WesternHAB/HAB360/README.md

# HAB360

This repository is for WesternU HAB team's VR balloon project. The goal is to fly 360° cameras on a balloon platform. The resulting video/images could then be viewed using VR cameras for outreach purposes.
