WesternHAB/HAB360/L-COM system/Documentation/Images/DrawIO/status_packet.png

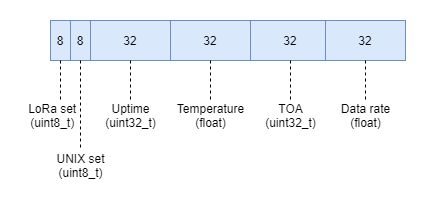
L-COM system/Documentation/Images/DrawIO/status_packet.png
