WesternHAB/HAB360/L-COM system/Documentation/Images/serial_power_interface.jpg

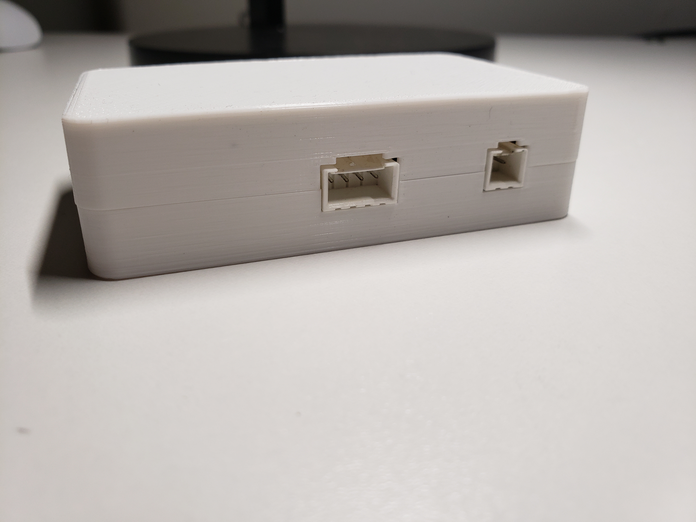
L-COM system/Documentation/Images/serial_power_interface.jpg
