WesternHAB/HAB360/L-COM system/Documentation/LCOM_V2_specifications.xlsx

Sheet: Eagle parts list
Part type: | Capacitors |  |  | Part type: | Resistors |  |  | Part type: | Inductors
Name | Footprint | Value | Notes | Name | Footprint | Value | Notes | Name | Footprint | Value | Notes
C1 | 0805 | 10uF | 50V min | R1 | 0805 | 1K |  | L1 | CD43 | 5.6uH | RLS-567, 12-48V?
C2 | 0805 | 100nF | 50V min | R2 | 0805 | 0R
C3 | 0805 | 100nF |  | R3 | 0805 | 10K
C4 | 0805 | 10uF |  | R4 | 0805 | 10K-Therm | Thermistor | Part type: | Diodes
C5 | 0805 | 1uF |  | R5 | 0805 | 200R |  | Name | Footprint | Model | Notes
C6 | 0805 | 1uF |  | R6 | 0805 | 1K |  | D1 | 0603 | 1N4148WT
C7 | 0805 | 1nF |  | R7 | 0805 | 200R |  | ZD1 | 1206 | MMSZ4690T1G
C8 | 0805 | 100nF |  | R8 | 0805 | 1K8
C9 | 1206 (3216) | 33uF | 10V tantalum | R9 | 0805 | 1K
C10 | 0805 | 10nF |  | R10 | 0805 | 10K |  | Part type: | LEDs
C11 | 0805 | 100nF |  | R11 | 0805 | 4K7 |  | Name | Footprint | Colour | Notes
C12 | 0805 | 100nF |  | R12 | 0805 | 4K7 |  | LED_TX | 0805 | Green
C13 | 0805 | 10nF |  |  |  |  |  | LED_RX | 0805 | Green
C14 | 0805 | 10nF |  |  |  |  |  | LED_PWR | 0805 | Red
C15 | 1206 (3216) | 33uF | 10V tantalum
C16 | 0805 | 100nF
C17 | 1206 | 100nF
Part type: | Connectors |  |  | Part type: | Voltage regulators |  |  | Part type: | Microcontroller
Name | Type |  | Notes | Name | Type |  | Notes | Name | Part |  | Notes
ICSP | 6-pin ICSP |  |  | U1 | R-78C5.0-1.0 |  |  | MCU1 | ATMEGA328P-AU |  |  | Need a 328 for program memory and SRAM requirements.
MX1 | 2-pin Molex Mini-Lock |  |  | U2 | TLV75733PDBVR |  |  | Y1 | ECS-TXO-2016-33-120-TR |  | Clock source
MX2 | 4-pin Molex Mini-Lock
FH1 | 2x15 2.54mm pitch female header
X1 | SMA edge-connector (plug, male pin) |  |  |  |  |  |  | Part type: | Fuses
 |  |  |  |  |  |  |  | Name | Footprint | Value | Model | Notes
 |  |  |  |  |  |  |  | F1 | 0805 | 1A
Part type: | Miscellaneous
Name | Type |  | Notes
SW1 | Tactile switch
EBYTE | EBYTE_900M_30S
4x M2 screws

Sheet: Order list
Part type: | Capacitors |  |  |  |  | All capacitors are cheaper in bulk.
Value | Footprint | Quantity | Digikey | Price | Notes | If close to to a price break quantity, just add a few extra (May be overall cheaper, or extra parts for later).
1nF | 0805 | 1 | https://www.digikey.ca/en/products/detail/kemet/C0805C102K4RACTU/2211681 | $0.20
10nF | 0805 | 3 | https://www.digikey.ca/en/products/detail/kemet/C0805C103K4RACTU/2211721 | $0.20
100nF | 0805 | 7 | https://www.digikey.ca/en/products/detail/kemet/C0805C104K5RACTU/411169 | $0.21 | Rated 50V
1uF | 0805 | 2 | https://www.digikey.ca/en/products/detail/kemet/C0805C105K4RACTU/416047 | $0.19
10uF | 0805 | 2 | https://www.digikey.ca/en/products/detail/kemet/C0805C106K3PAC7800/5267604 | $0.38 | 25V, get higher? | Derating by 50% allows us 12V. Max input to regulator is 42V (but that’s way too high). Go for a 50V 1206 later. Or one 0805 for 5V output, and a 1206 for the Vin.
33uF | 1206 (3216) | 2 | https://www.digikey.ca/en/products/detail/kemet/T491A336K010AT/1842019 | $0.92 | 10V tantalums
Cheaper tantalums: | https://www.digikey.ca/en/products/detail/avx-corporation/TAJA226K010TNJ/7566973
Part type: | Resistors |  |  |  |  | All resistors are cheaper in bulk.
Value | Footprint | Quantity | Digikey | Price | Notes | If close to to a price break quantity, just add a few extra (May be overall cheaper, or extra parts for later).
0R | 0805 | 2 | https://www.digikey.ca/en/products/detail/stackpole-electronics-inc/RMCF0805ZT0R00/1756901 | $0.15
200R | 0805 | 2 | https://www.digikey.ca/en/products/detail/stackpole-electronics-inc/RNCP0805FTD200R/2240213 | $0.15
1K | 0805 | 3 | https://www.digikey.ca/en/products/detail/stackpole-electronics-inc/RNCP0805FTD1K00/2240229 | $0.15
1K8 | 0805 | 1 | https://www.digikey.ca/en/products/detail/stackpole-electronics-inc/RMCF0805JT1K80/1757793 | $0.15
4K7 | 0805 | 2 | https://www.digikey.ca/en/products/detail/stackpole-electronics-inc/RMCF0805FT4K70/1760659 | $0.15
10k | 0805 | 2 | https://www.digikey.ca/en/products/detail/stackpole-electronics-inc/RNCP0805FTD10K0/2240262 | $0.15
10k thermistor | 0805 | 1 | https://www.digikey.ca/en/products/detail/te-connectivity-passive-product/NTC0805J10K/2363788?\ | $1.62
Part type: | Inductors
Value | Footprint | Quantity | Digikey | Price | Notes
5.6uH | CD43 | 1 | https://www.digikey.ca/en/products/detail/recom-power/RLS-567/9920569 | $1.08 | RLS-567
Part type: | Diodes
Model | Footprint | Quantity | Digikey | Price | Notes
1N4148WT | 0603 | 1 | https://www.digikey.ca/en/products/detail/on-semiconductor/1N4148WT/2094398 | $0.25
MMSZ4690T1G | 1206 | 1 | https://www.digikey.ca/en/products/detail/on-semiconductor/MMSZ4690T1G/964645 | $0.30 |  |  | Rough power estimates
 |  |  |  |  |  |  | Nominal ratings |  | Maximum ratings
 |  |  |  |  |  |  | Current (mA) | Power draw (mW) | Max current (mA) | Power draw (mW)
Part type: | LEDs
Colour | Footprint | Quantity | Digikey | Price | Notes
Red | 0805 | 1 | https://www.digikey.ca/en/products/detail/w%C3%BCrth-elektronik/150080RS75000/4489918 | $0.26 |  |  | 20 | 40 | 100 | 72 | @2V
Green | 0805 | 2 | https://www.digikey.ca/en/products/detail/w%C3%BCrth-elektronik/150080VS75000/4489924 | $0.26 |  |  | 20 | 40 | 100 | 72 | @2V
Part type: | Voltage regulators
Model |  | Quantity | Digikey | Price | Notes
R-78C5.0-1.0 |  | 1 | https://www.digikey.ca/en/products/detail/recom-power/R-78C5.0-1.0/2652148 | $12.85 | 1mA Quiesscent | 5A out
TLV75733PDBVR |  | 1 | https://www.digikey.ca/en/products/detail/texas-instruments/TLV75733PDBVR/9343364 | $0.88 | 25uA Quiesscent | 1A out
Part type: | Fuses
Value | Footprint | Quantity | Digikey | Price | Notes
1A | 0805 | 1 | https://www.digikey.ca/en/products/detail/vishay-beyschlag-draloric-bc-components/MFU0805FF01000P100/1206490 | $0.71 | >= 10V
Might as well grab a 1.25A fuse too: |  | https://www.digikey.ca/en/products/detail/vishay-beyschlag-draloric-bc-components/MFU0805FF01250P100/1206491
Part type: | Microcontroller
Model |  | Quantity | Digikey | Price | Notes
ATMEGA328P-AU |  | 1 | https://www.digikey.ca/en/products/detail/microchip-technology/ATMEGA328P-AU/1832260 | $3.09 |  |  | 6 | 19.8 | 12 | 39.6 | @3.3V
ECS-TXO-2016-33-120-TR |  | 1 | https://www.digikey.ca/en/products/detail/ecs-inc/ECS-TXO-2016-33-120-TR/10244143 | $2.12 |  |  | 5 | 16.5 | 5 | 16.5 | @3.3V
Part type: | Miscellaneous
Model |  | Quantity | Digikey | Price | Notes
Tactile switch |  | 1 | https://www.digikey.com/en/products/detail/w%C3%BCrth-elektronik/430152043826/5208994 | $0.49
EBYTE_900M_30S |  | 1 | http://www.ebyte.com/en/product-view-news.aspx?id=453 | $13.44 |  |  | 650 | 3250 | 750 | 3750 | @5V | Guessed 750mA as max draw, but no value given
Part type: | Connectors
Type | Number of pins | Quantity | Digikey | Price | Notes
ICSP | 6 | 1 | https://www.digikey.ca/en/products/detail/amphenol-icc-fci/69168-106HLF/1002738 | $0.65 | TEST PART
Molex Mini-Lock | 2 | 1 | https://www.digikey.ca/en/products/detail/molex/0534260210/2405259 | $0.49
Molex Mini-Lock | 4 | 1 | https://www.digikey.ca/en/products/detail/molex/0534260410/2405238 | $0.62
Female header | 2x15 | 1 | https://www.digikey.ca/en/products/detail/sullins-connector-solutions/PPTC152LFBN-RC/810221 | $2.63
SMA plug/male-pin | 1 | 1 | https://www.digikey.ca/en/products/detail/molex/0732511150/1465156 | $4.97
Cheaper SMA: | https://www.digikey.ca/en/products/detail/rf-solutions/CON-SMA-EDGE-S/5845767
The footprint is smaller though
Part type: | PCB
Model | Manufacturer | Quantity | Manufacturer website | Price | Notes
LCOM_V1 | Oshpark | 1 | https://oshpark.com/ | $8.07 | Must buy 3
Part type: | Case
Model | Manufacturer | Quantity | Manufacturer website | Price | Notes
? | ? | 1 | ? | $0.00
 |  |  |  |  |  |  | mA | mW | mA | mW
 |  |  |  | $62.09 |  |  | 701 | 3366.3 | 967 | 3950.1
Either choose to buy preassembled (more expensive) cables or assemble them yourself.
Part type: | Male-male Molex Mini-Lock connectors (individual parts)
Type | Number of pins | Quantity | Digikey | Price | Notes
Socket contact crimp | 1 | 1 | https://www.digikey.ca/en/products/detail/molex/0503518000/2405712 | $0.14
Mini-Lock male | 4 | 1 | https://www.digikey.ca/en/products/detail/molex/0511630400/3262548 | $0.38
Mini-Lock male | 2 | 1 | https://www.digikey.ca/en/products/detail/molex/0511630200/3262546 | $0.27
Part type: | Male-male Molex Mini-Lock connectors (prebuilt)
Type | Number of pins | Quantity | Digikey | Price | Notes
Mini-Lock male | 4 | 1 | https://www.digikey.ca/en/products/detail/molex/0151370402/9759738 | $6.29
Mini-Lock male | 2 | 1 | https://www.digikey.ca/en/products/detail/molex/0151370202/9759726 | $4.74

Sheet: Comms module specs
Vin input (2-pin)
Range: 8V to 42V. Reccomended 12V.
5V input (4-pin)
Range: ~5V.
Should be as close to 5V as possible (EBYTE performance depends on it).
If bypassing the 8-42V to 5V regulator this way, MUST be a stable/regulated power supply to avoid brownouts and damage.
3.3V ICSP header (programming)
Range: 3.3V (DO NOT USE A 5V PROGRAMMER)
The rest of the board should be receiving power via Vin or 5V input to avoid possible damage to the EBYTE module (in the case that the EBYTE is unpowered - ATMEGA data lines are connected to it and may cause damage).
Pin header Vin, 5V, 3.3V
Powering via the pin header - use the specifications listed above for the appropriate pin.

Sheet: Pin mappings
ATMEGA pin | Digital pin | Used for | Notes
PB0 | 8 | BUSY
PB1 | 9 | NRST
PB2 | 10 | NSS
PB3 | 11 | MOSI | SPI (Shared with EBYTE)
PB4 | 12 | MISO | SPI (Shared with EBYTE)
PB5 | 13 | SCK | SPI (Shared with EBYTE)
PB6 | XTAL1 | CLOCK | If trouble programming, can attach an external clock on this pin.
PB7 | XTAL2
PC0 | A0 | Thermistor | Optional, connect via 0R resistor.
PC1 | A1 |  | Analog
PC2 | A2 |  | Analog
PC3 | A3 |  | Analog
PC4 | A4 |  | I2C
PC5 | A5 |  | I2C
PC6 | RESET | RESET
PD0 | 0 | RX | Serial/UART
PD1 | 1 | TX | Serial/UART
PD2 | 2 | DIO1
PD3 | 3 | DIO2 | Optional, connect via 0R resistor.
PD4 | 4
PD5 | 5
PD6 | 6 | RF RX | If split antenna, RX switch on this pin.
PD7 | 7 | RF TX | If split antenna, TX switch on this pin. Can control external amplifier as well.
ADC6 |  |  | ADC
ADC7 |  |  | ADC

Sheet: Version changes
Version | Changes
V1 | ~
V2 | Mapped DIO2 to PD2, pushed back groundplane from Vin traces, removed R14, moved R13 to connect DIO2
