WesternHAB/HAB360/L-COM system/EAGLE files/comms_sys_schematic_V2.brd

## EAGLE design L-COM system/EAGLE files/comms_sys_schematic_V2.brd (2021-02-04)

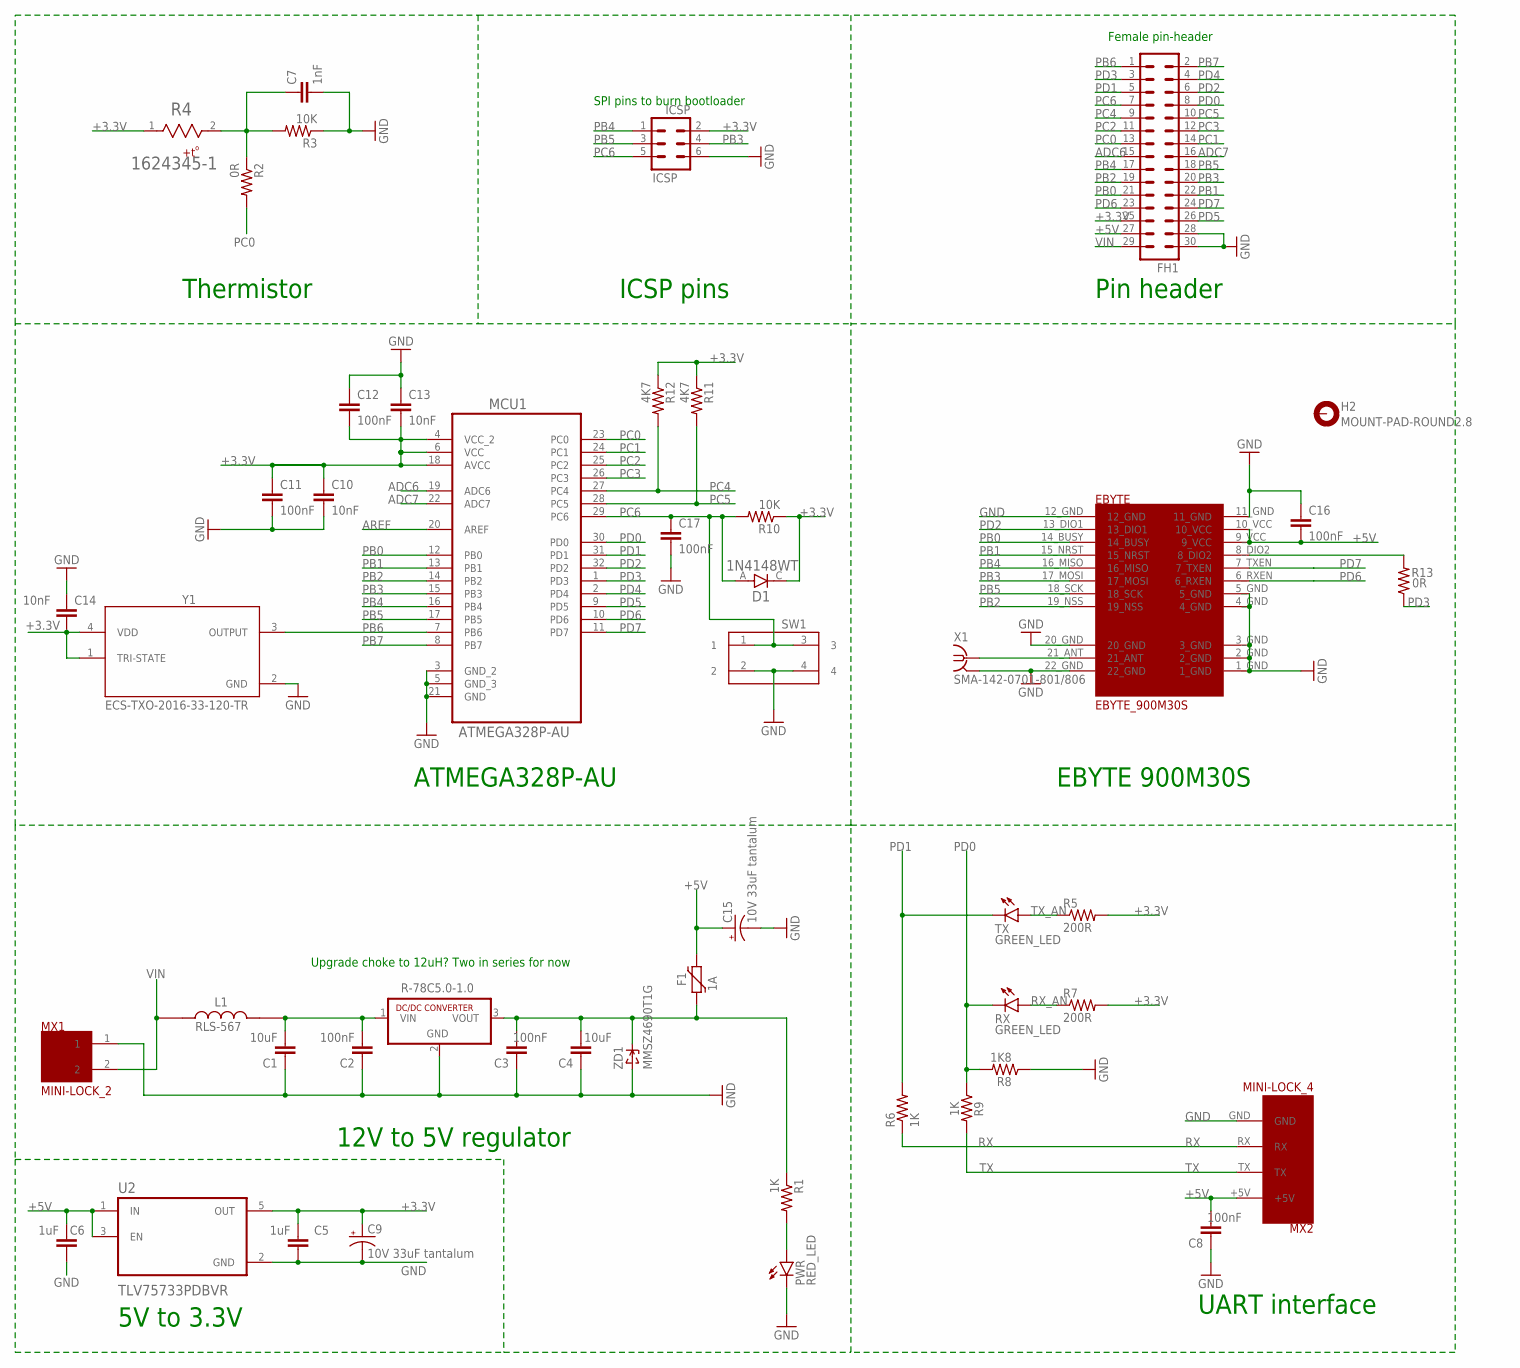
[picture p22: schematic comms_sys_schematic_V2.sch]

Parts:
C1, C4: 10uF; C0805
C2, C3, C8, C11, C12, C16, C17: 100nF; C0805
C5, C6: 1uF; C0805
C7: 1nF; C0805
C9, C15: 10V 33uF tantalum; CT3216
C10, C13, C14: 10nF; C0805
D1: 1N4148WT; SODFL1608X70N
EBYTE: EBYTE_900M30S; EBYTE_SX1262_900M30S_FOOTPRINT
F1: 1A; PTC0805
FH1: MA15-2
H2: MOUNT-PAD-ROUND2.8; 2,8-PAD
ICSP: ICSP; MA03-2
L1: RLS-567; IND_RLS-567
MCU1: ATMEGA328P-AU; QFP80P900X900X120-32N
MX1: MINI-LOCK_2
MX2: MINI-LOCK_4
PWR: RED_LED; CHIP-LED0805
R1, R6, R9: 1K; R0805
R2, R13: 0R; R0805
R3, R10: 10K; R0805
R4: 1624345-1; THRMC2012X50N
R5, R7: 200R; R0805
R8: 1K8; R0805
R11, R12: 4K7; R0805
RX: GREEN_LED; CHIP-LED0805
SW1: 430152043826
TX: GREEN_LED; CHIP-LED0805
U1: R-78C5.0-1.0; SIP3
U2: TLV75733PDBVR; SOT95P280X145-5N
X1: SMA-142-0701-801/806; J502-ND-142-0701-801/806
Y1: ECS-TXO-2016-33-120-TR; OSC_ECS-TXO-2016-33-120-TR
ZD1: MMSZ4690T1G; SOD-123

Connections:
$N77: C7.1, R2.1, R3.2, R4.2
+3.3V: C5.2, C9.+, C10.1, C11.1, C12.2, C13.2, C14.2, D1.C, FH1.25 (29), ICSP.2, MCU1.4 (VCC_2), MCU1.6 (VCC), MCU1.18 (AVCC), R4.1, R5.2, R7.2, R10.1, R11.1, R12.1, U2.5 (OUT), Y1.1 (TRI-STATE), Y1.4 (VDD)
+5V: C6.2, C8.2, C15.+, C16.2, EBYTE.9_VCC, EBYTE.10_VCC, F1.2, FH1.27 (31), MX2.+5V, U2.1 (IN), U2.3 (EN)
ADC6: FH1.15 (19), MCU1.19 (ADC6)
ADC7: FH1.16 (20), MCU1.22 (ADC7)
AREF: MCU1.20 (AREF)
GND: C1.1, C2.1, C3.1, C4.1, C5.1, C6.1, C7.2, C8.1, C9.-, C10.2, C11.2, C12.1, C13.1, C14.1, C15.-, C16.1, C17.2, EBYTE.1_GND, EBYTE.2_GND, EBYTE.3_GND, EBYTE.4_GND, EBYTE.5_GND, EBYTE.11_GND, EBYTE.12_GND, EBYTE.20_GND, EBYTE.22_GND, FH1.28 (32), FH1.30 (34), ICSP.6, MCU1.3 (GND_2), MCU1.5 (GND_3), MCU1.21 (GND), MX1.1, MX2.GND, PWR.C, R3.1, R8.1, SW1.2, SW1.4, U1.2 (GND), U2.2 (GND), X1.G@1 (2), X1.G@2 (2), X1.G@3 (2), X1.G@4 (2), Y1.2 (GND), ZD1.A
unnamed: C3.2, C4.2, F1.1, R1.1, U1.3 (VOUT), ZD1.C
unnamed: EBYTE.8_DIO2, R13.2
unnamed: PWR.A, R1.2
unnamed: EBYTE.21_ANT, X1.1
unnamed: C1.2, C2.2, L1.2, U1.1 (VIN)
PB0: EBYTE.14_BUSY, FH1.21 (25), MCU1.12 (PB0)
PB1: EBYTE.15_NRST, FH1.22 (26), MCU1.13 (PB1)
PB2: EBYTE.19_NSS, FH1.19 (23), MCU1.14 (PB2)
PB3: EBYTE.17_MOSI, FH1.20 (24), ICSP.4, MCU1.15 (PB3)
PB4: EBYTE.16_MISO, FH1.17 (21), ICSP.1, MCU1.16 (PB4)
PB5: EBYTE.18_SCK, FH1.18 (22), ICSP.3, MCU1.17 (PB5)
PB6: FH1.1 (5), MCU1.7 (PB6), Y1.3 (OUTPUT)
PB7: FH1.2 (6), MCU1.8 (PB7)
PC0: FH1.13 (17), MCU1.23 (PC0), R2.2
PC1: FH1.14 (18), MCU1.24 (PC1)
PC2: FH1.11 (15), MCU1.25 (PC2)
PC3: FH1.12 (16), MCU1.26 (PC3)
PC4: FH1.9 (13), MCU1.27 (PC4), R12.2
PC5: FH1.10 (14), MCU1.28 (PC5), R11.2
PC6: C17.1, D1.A, FH1.7 (11), ICSP.5, MCU1.29 (PC6), R10.2, SW1.1, SW1.3
PD0: FH1.8 (12), MCU1.30 (PD0), R8.2, R9.1, RX.C
PD1: FH1.5 (9), MCU1.31 (PD1), R6.2, TX.C
PD2: EBYTE.13_DIO1, FH1.6 (10), MCU1.32 (PD2)
PD3: FH1.3 (7), MCU1.1 (PD3), R13.1
PD4: FH1.4 (8), MCU1.2 (PD4)
PD5: FH1.26 (30), MCU1.9 (PD5)
PD6: EBYTE.6_RXEN, FH1.23 (27), MCU1.10 (PD6)
PD7: EBYTE.7_TXEN, FH1.24 (28), MCU1.11 (PD7)
RX: MX2.RX, R6.1
RX_AN: R7.1, RX.A
TX: MX2.TX, R9.2
TX_AN: R5.1, TX.A
VIN: FH1.29 (33), L1.1, MX1.2

Notes on the sheet:
SPI pins to burn bootloader
12V to 5V regulator
Upgrade choke to 12uH? Two in series for now
UART interface
5V to 3.3V
ATMEGA328P-AU
EBYTE 900M30S
Pin header
ICSP pins
Thermistor
Female pin-header

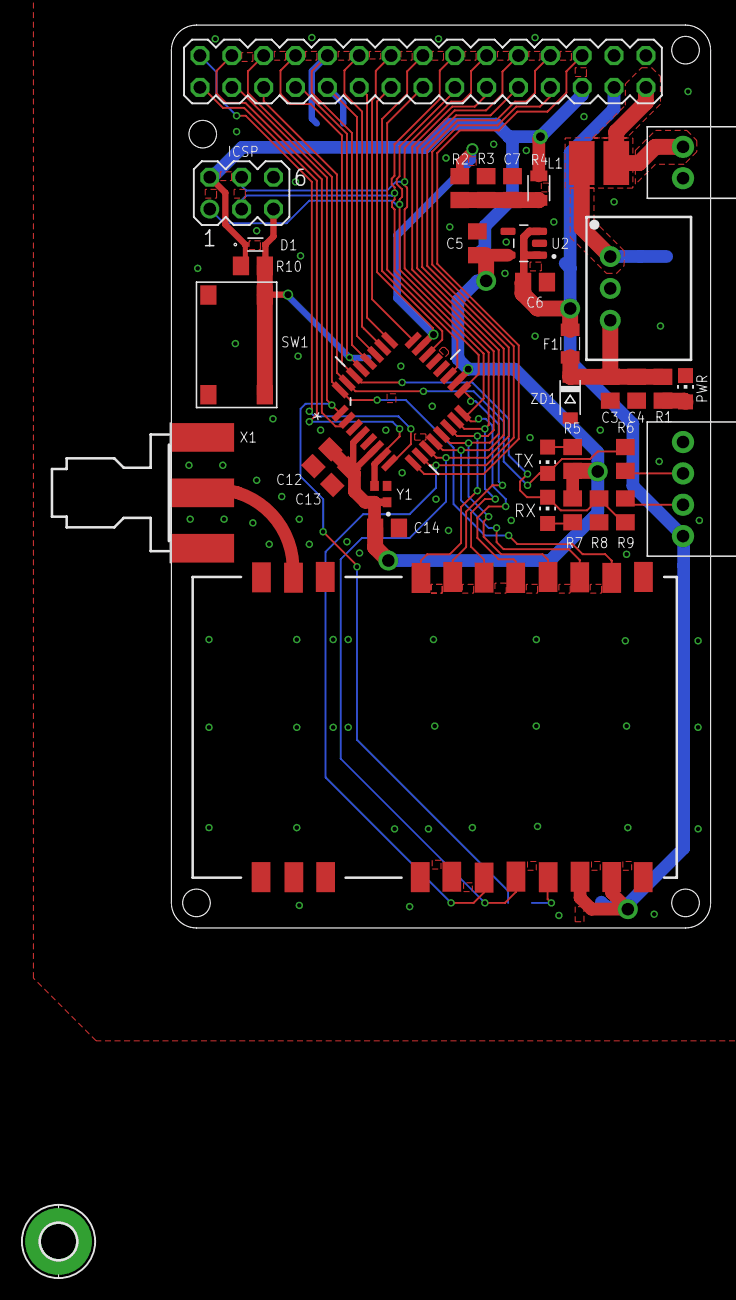
[picture p23: board comms_sys_schematic_V2.brd from above]

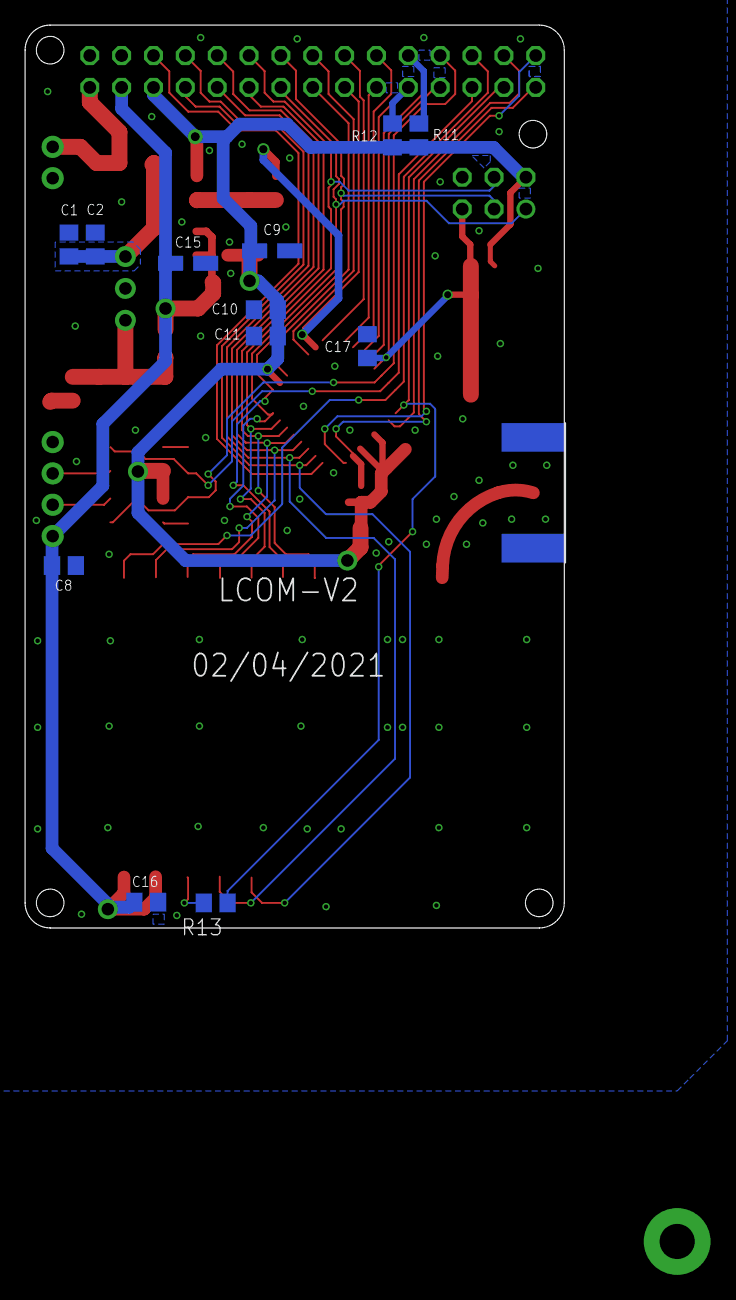
[picture p24: board comms_sys_schematic_V2.brd from below]

Board: 2 copper layers, 43.0 x 72.0 mm, 49 parts (12 on the bottom side), 39 nets.
