WesternHAB/HAB360/L-COM system/EAGLE files/_archive/Testing adapters/Ebyte 900M30S adapter/scem.brd

## EAGLE design L-COM system/EAGLE files/_archive/Testing adapters/Ebyte 900M30S adapter/scem.brd (2020-06-25, an earlier design)

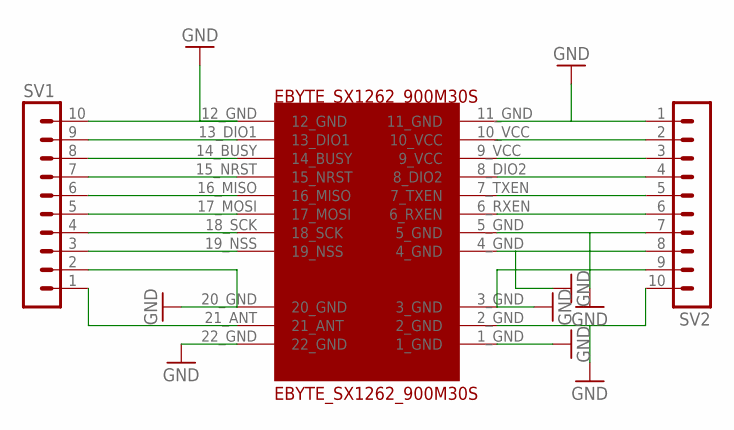
[picture p25: schematic scem.sch]

Parts:
EBYTE_SX1262_900M30S: EBYTE_SX1262_900M30S; EBYTE_SX1262_900M30S_FOOTPRINT
SV1, SV2: MA10-1

Connections:
GND: EBYTE_SX1262_900M30S.1_GND, EBYTE_SX1262_900M30S.2_GND, EBYTE_SX1262_900M30S.3_GND, EBYTE_SX1262_900M30S.4_GND, EBYTE_SX1262_900M30S.5_GND, EBYTE_SX1262_900M30S.11_GND, EBYTE_SX1262_900M30S.12_GND, EBYTE_SX1262_900M30S.20_GND, EBYTE_SX1262_900M30S.22_GND, SV1.2, SV1.10, SV2.1, SV2.7, SV2.8, SV2.9, SV2.10
unnamed: EBYTE_SX1262_900M30S.13_DIO1, SV1.9
unnamed: EBYTE_SX1262_900M30S.14_BUSY, SV1.8
unnamed: EBYTE_SX1262_900M30S.15_NRST, SV1.7
unnamed: EBYTE_SX1262_900M30S.16_MISO, SV1.6
unnamed: EBYTE_SX1262_900M30S.17_MOSI, SV1.5
unnamed: EBYTE_SX1262_900M30S.18_SCK, SV1.4
unnamed: EBYTE_SX1262_900M30S.19_NSS, SV1.3
unnamed: EBYTE_SX1262_900M30S.21_ANT, SV1.1
unnamed: EBYTE_SX1262_900M30S.10_VCC, SV2.2
unnamed: EBYTE_SX1262_900M30S.9_VCC, SV2.3
unnamed: EBYTE_SX1262_900M30S.8_DIO2, SV2.4
unnamed: EBYTE_SX1262_900M30S.7_TXEN, SV2.5
unnamed: EBYTE_SX1262_900M30S.6_RXEN, SV2.6

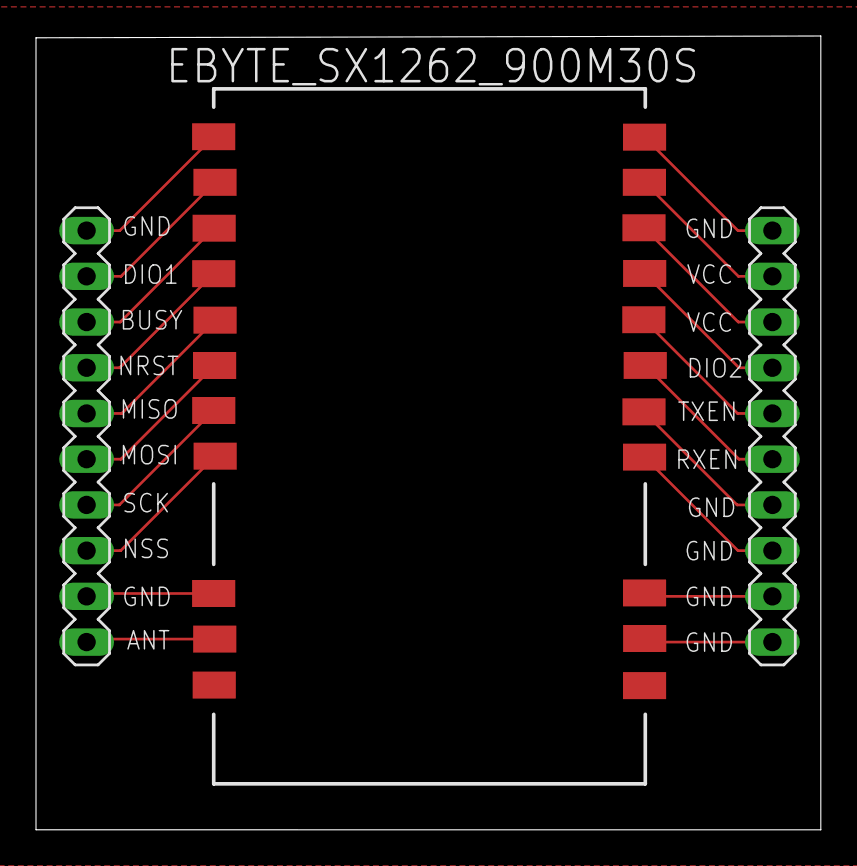
[picture p26: board scem.brd from above]

Board: 2 copper layers, 43.6 x 44.1 mm, 3 parts (0 on the bottom side), 14 nets.
