WesternHAB/HAB360/L-COM system/EAGLE files/_archive/Communication_module/comms_sys_schematic_R2.brd

## EAGLE design L-COM system/EAGLE files/_archive/Communication_module/comms_sys_schematic_R2.brd (2020-10-02, an earlier design)

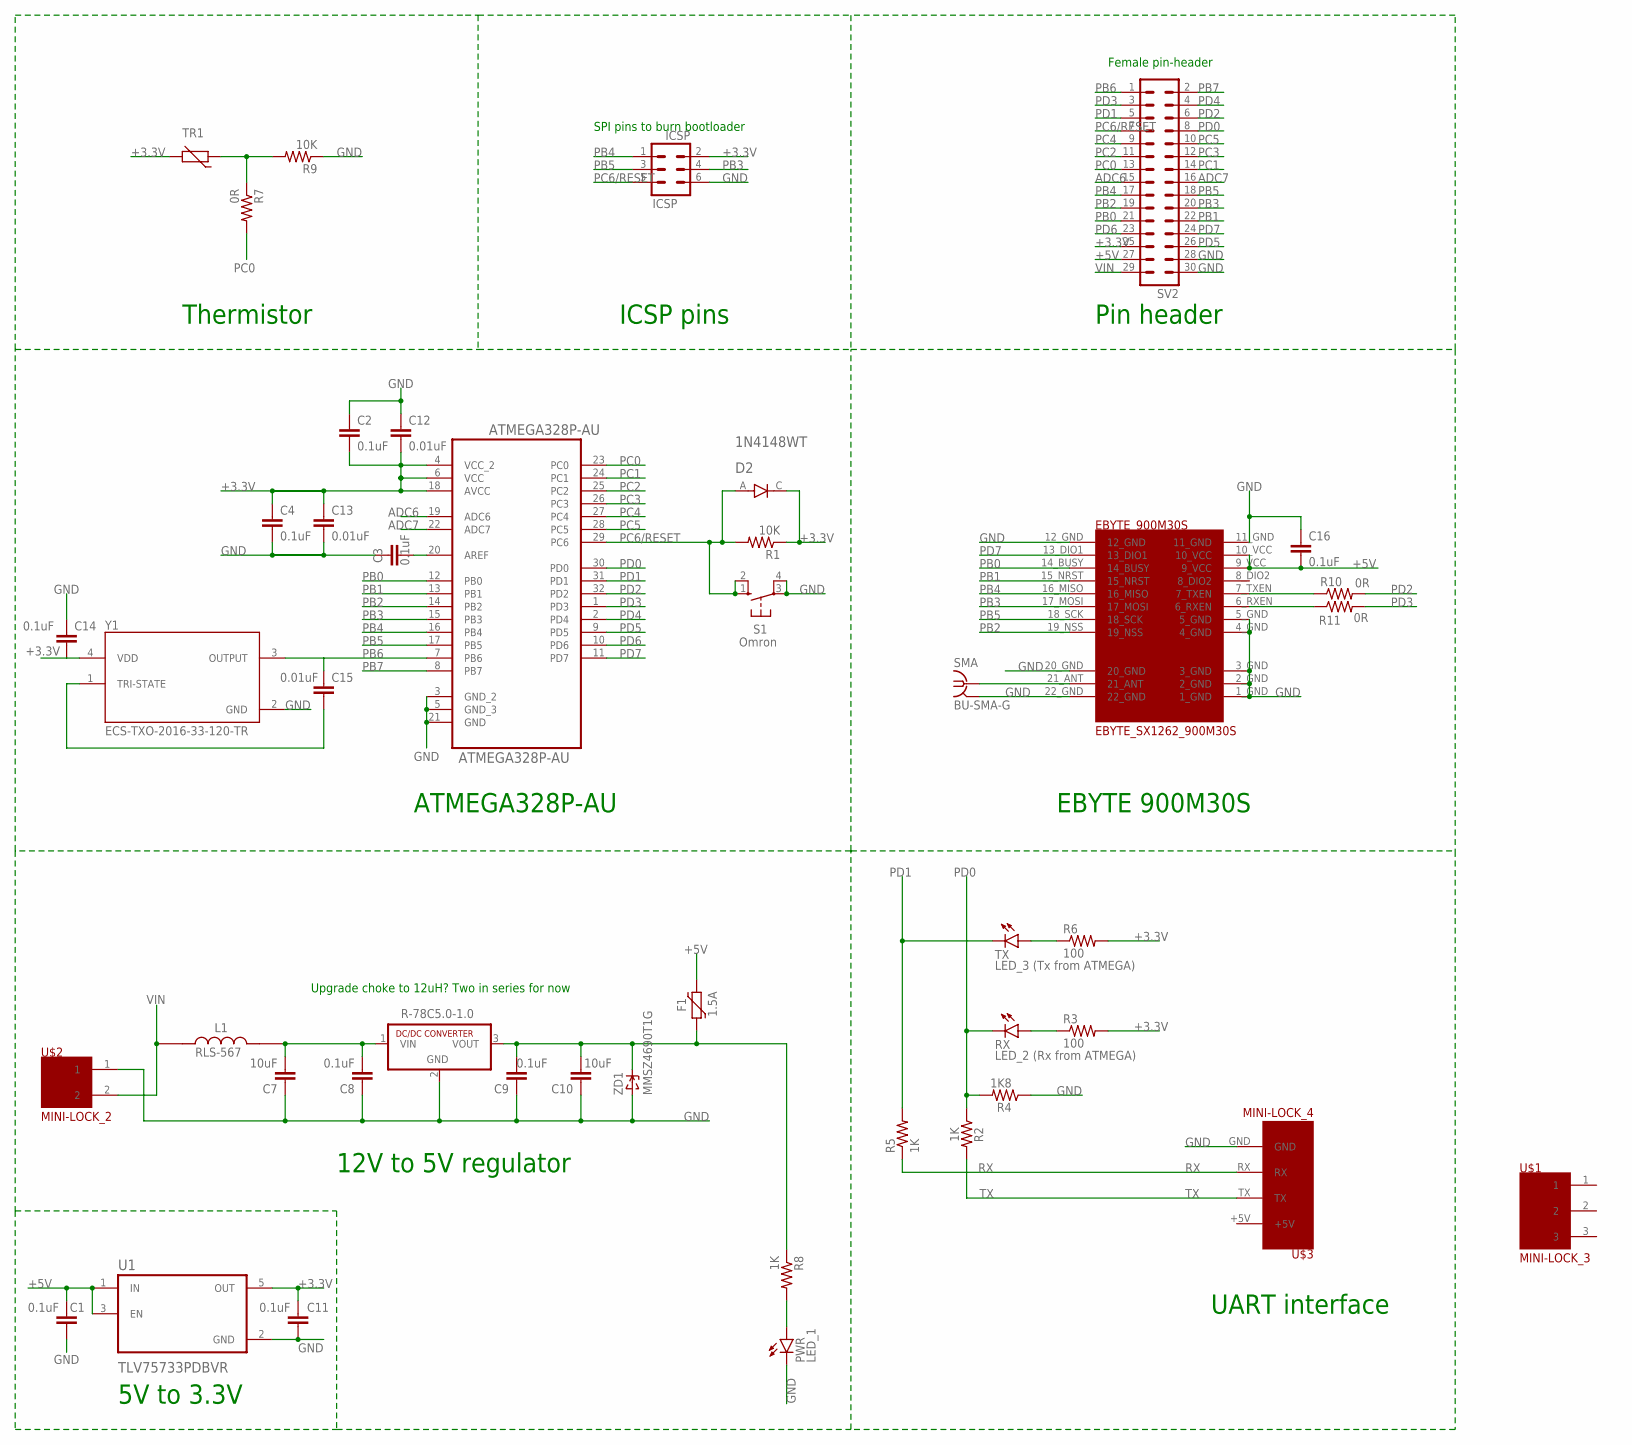
[picture p27: schematic comms_sys_schematic_R2.sch]

Parts:
ATMEGA328P-AU: ATMEGA328P-AU; QFP80P900X900X120-32N
C1, C2, C3, C4, C8, C9, C11, C14, C16: 0.1uF; C0805
C7, C10: 10uF; C0805
C12, C13, C15: 0.01uF; C0805
D2: 1N4148WT; SODFL1608X70N
EBYTE_900M30S: EBYTE_SX1262_900M30S; EBYTE_SX1262_900M30S_FOOTPRINT
F1: 1.5A; PTC0805
ICSP: ICSP; MA03-2
L1: RLS-567; IND_RLS-567
PWR: LED_1; CHIP-LED0805
R1, R9: 10K; R0805
R2, R5, R8: 1K; R0805
R3, R6: 100; R0805
R4: 1K8; R0805
R7, R10, R11: 0R; R0805
R-78C5.0-1.0: R-78C5.0-1.0; SIP3
RX: LED_2 (Rx from ATMEGA); CHIP-LED0805
S1: Omron; B3F-10XX
SMA: BU-SMA-G
SV2: MA15-2
TR1: THERMISTOR_R-2,5; RS-2,5
TX: LED_3 (Tx from ATMEGA); CHIP-LED0805
U1: TLV75733PDBVR; SOT95P280X145-5N
U$1: MINI-LOCK_3
U$2: MINI-LOCK_2
U$3: MINI-LOCK_4
Y1: ECS-TXO-2016-33-120-TR; OSC_ECS-TXO-2016-33-120-TR
ZD1: MMSZ4690T1G; SOD-123

Connections:
$N77: R7.1, R9.2, TR1.1
+3.3V: ATMEGA328P-AU.4 (VCC_2), ATMEGA328P-AU.6 (VCC), ATMEGA328P-AU.18 (AVCC), C2.2, C4.1, C11.2, C12.2, C13.1, C14.2, D2.C, ICSP.2, R1.1, R3.2, R6.2, SV2.25 (29), TR1.2, U1.5 (OUT), Y1.4 (VDD)
+5V: C1.2, C16.2, EBYTE_900M30S.9_VCC, EBYTE_900M30S.10_VCC, F1.2, SV2.27 (31), U1.1 (IN), U1.3 (EN)
ADC6: ATMEGA328P-AU.19 (ADC6), SV2.15 (19)
ADC7: ATMEGA328P-AU.22 (ADC7), SV2.16 (20)
GND: ATMEGA328P-AU.3 (GND_2), ATMEGA328P-AU.5 (GND_3), ATMEGA328P-AU.21 (GND), C1.1, C2.1, C3.1, C4.2, C7.1, C8.1, C9.1, C10.1, C11.1, C12.1, C13.2, C14.1, C16.1, EBYTE_900M30S.1_GND, EBYTE_900M30S.2_GND, EBYTE_900M30S.3_GND, EBYTE_900M30S.4_GND, EBYTE_900M30S.5_GND, EBYTE_900M30S.11_GND, EBYTE_900M30S.12_GND, EBYTE_900M30S.20_GND, EBYTE_900M30S.22_GND, ICSP.6, PWR.C, R4.1, R9.1, R-78C5.0-1.0.2 (GND), S1.3, S1.4 (P1), SMA.2, SMA.3 (2), SMA.4 (2), SMA.5 (2), SV2.28 (32), SV2.30 (34), U1.2 (GND), U$2.1, U$3.GND, Y1.2 (GND), ZD1.A
unnamed: C9.2, C10.2, F1.1, R8.1, R-78C5.0-1.0.3 (VOUT), ZD1.C
unnamed: PWR.A, R8.2
unnamed: C15.2, Y1.1 (TRI-STATE)
unnamed: EBYTE_900M30S.7_TXEN, R10.1
unnamed: EBYTE_900M30S.6_RXEN, R11.1
unnamed: EBYTE_900M30S.21_ANT, SMA.1
unnamed: R3.1, RX.A
unnamed: ATMEGA328P-AU.20 (AREF), C3.2
unnamed: R6.1, TX.A
unnamed: C7.2, C8.2, L1.2, R-78C5.0-1.0.1 (VIN)
PB0: ATMEGA328P-AU.12 (PB0), EBYTE_900M30S.14_BUSY, SV2.21 (25)
PB1: ATMEGA328P-AU.13 (PB1), EBYTE_900M30S.15_NRST, SV2.22 (26)
PB2: ATMEGA328P-AU.14 (PB2), EBYTE_900M30S.19_NSS, SV2.19 (23)
PB3: ATMEGA328P-AU.15 (PB3), EBYTE_900M30S.17_MOSI, ICSP.4, SV2.20 (24)
PB4: ATMEGA328P-AU.16 (PB4), EBYTE_900M30S.16_MISO, ICSP.1, SV2.17 (21)
PB5: ATMEGA328P-AU.17 (PB5), EBYTE_900M30S.18_SCK, ICSP.3, SV2.18 (22)
PB6: ATMEGA328P-AU.7 (PB6), C15.1, SV2.1 (5), Y1.3 (OUTPUT)
PB7: ATMEGA328P-AU.8 (PB7), SV2.2 (6)
PC0: ATMEGA328P-AU.23 (PC0), R7.2, SV2.13 (17)
PC1: ATMEGA328P-AU.24 (PC1), SV2.14 (18)
PC2: ATMEGA328P-AU.25 (PC2), SV2.11 (15)
PC3: ATMEGA328P-AU.26 (PC3), SV2.12 (16)
PC4: ATMEGA328P-AU.27 (PC4), SV2.9 (13)
PC5: ATMEGA328P-AU.28 (PC5), SV2.10 (14)
PC6/RESET: ATMEGA328P-AU.29 (PC6), D2.A, ICSP.5, R1.2, S1.1 (S), S1.2 (S1), SV2.7 (11)
PD0: ATMEGA328P-AU.30 (PD0), R2.1, R4.2, RX.C, SV2.8 (12)
PD1: ATMEGA328P-AU.31 (PD1), R5.2, SV2.5 (9), TX.C
PD2: ATMEGA328P-AU.32 (PD2), R10.2, SV2.6 (10)
PD3: ATMEGA328P-AU.1 (PD3), R11.2, SV2.3 (7)
PD4: ATMEGA328P-AU.2 (PD4), SV2.4 (8)
PD5: ATMEGA328P-AU.9 (PD5), SV2.26 (30)
PD6: ATMEGA328P-AU.10 (PD6), SV2.23 (27)
PD7: ATMEGA328P-AU.11 (PD7), EBYTE_900M30S.13_DIO1, SV2.24 (28)
RX: R5.1, U$3.RX
TX: R2.2, U$3.TX
VIN: L1.1, SV2.29 (33), U$2.2

Notes on the sheet:
SPI pins to burn bootloader
12V to 5V regulator
Upgrade choke to 12uH? Two in series for now
UART interface
5V to 3.3V
ATMEGA328P-AU
EBYTE 900M30S
Pin header
ICSP pins
Thermistor
Female pin-header

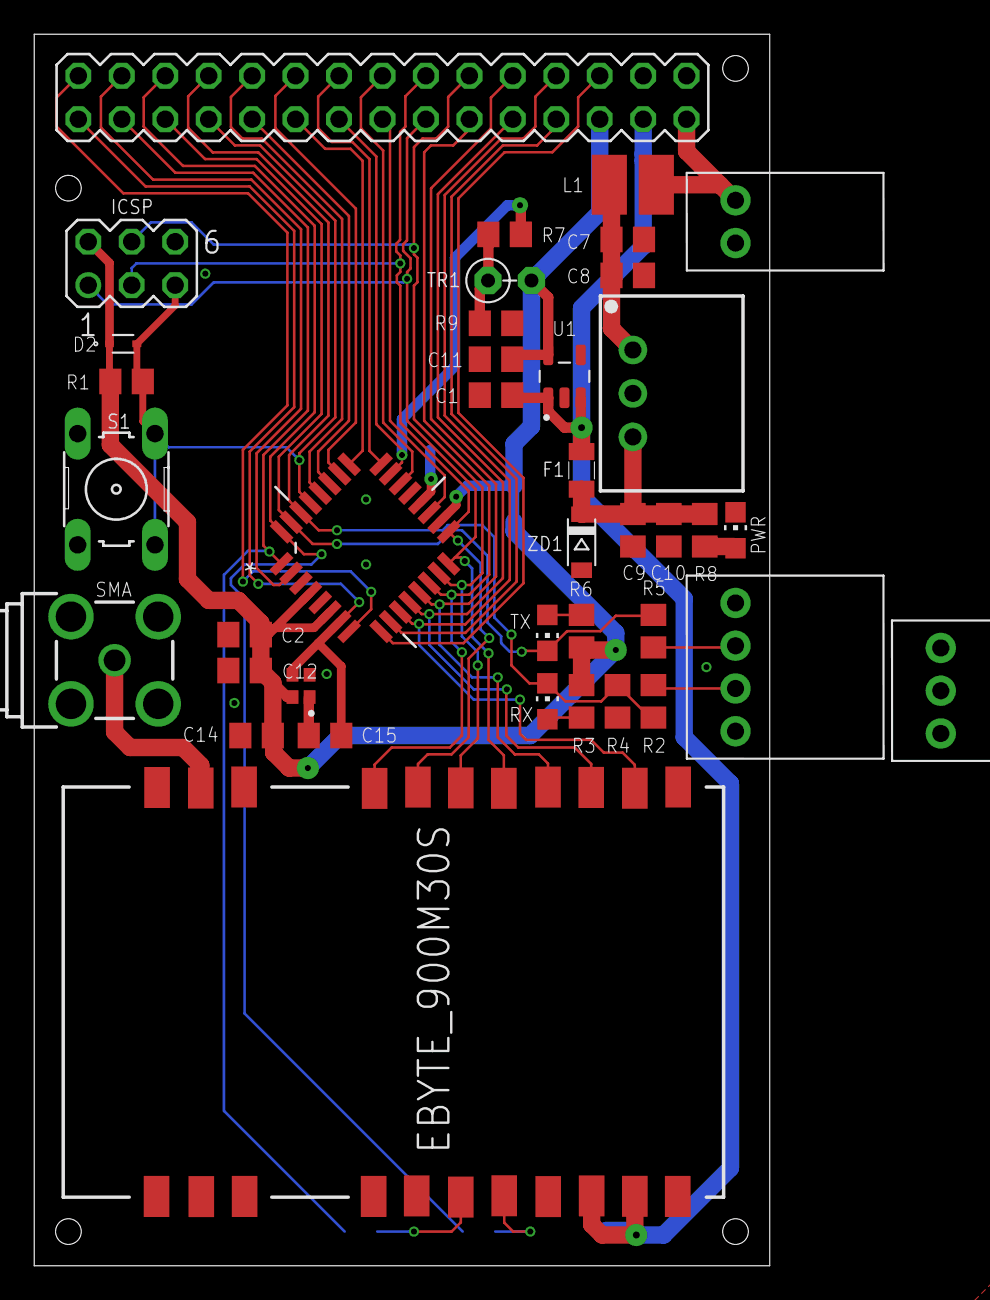
[picture p28: board comms_sys_schematic_R2.brd from above]

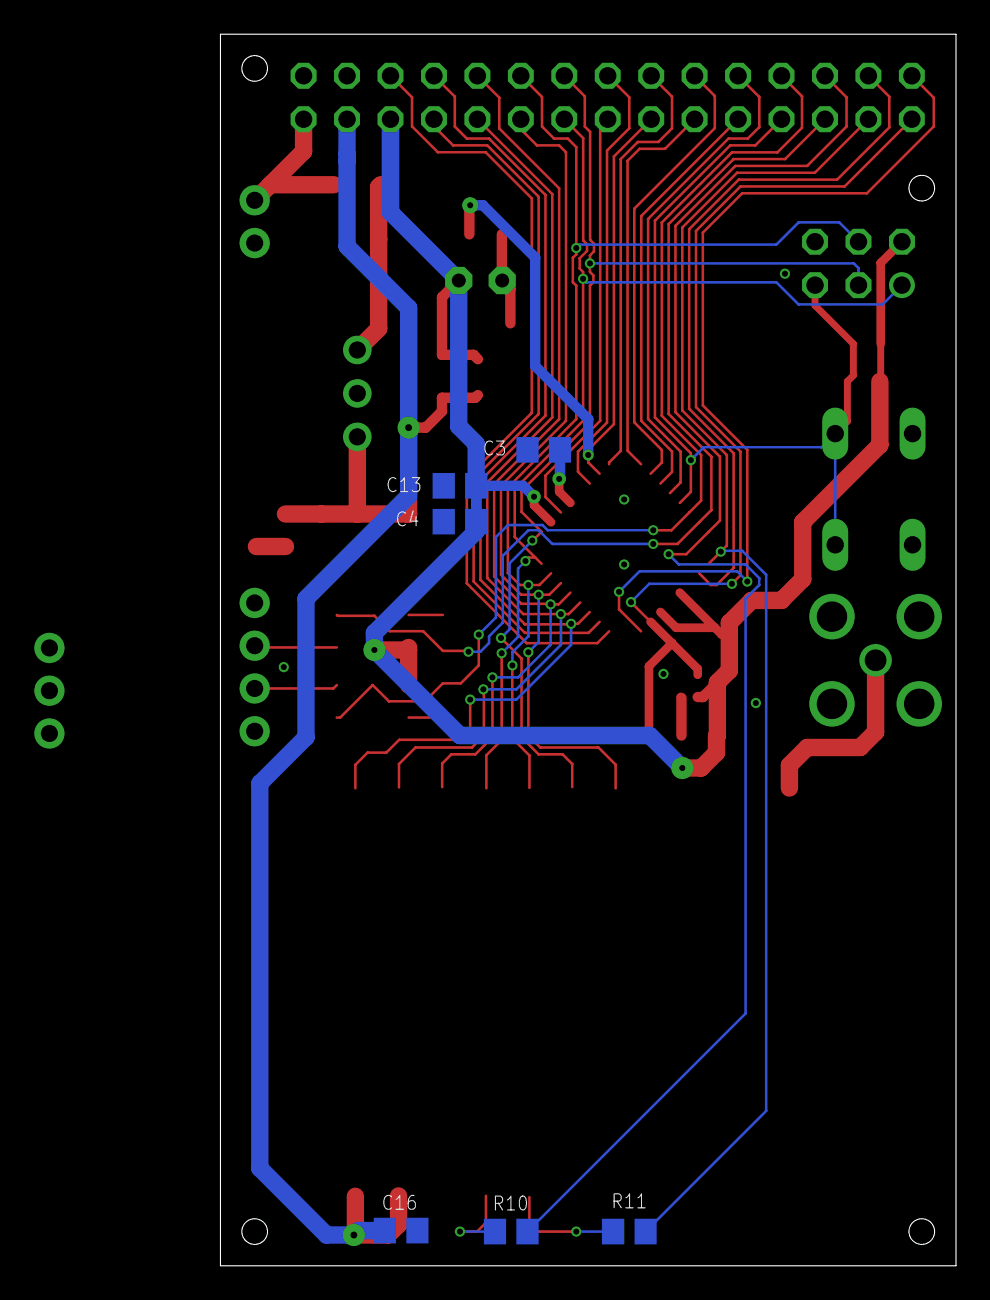
[picture p29: board comms_sys_schematic_R2.brd from below]

Board: 2 copper layers, 43.0 x 72.0 mm, 45 parts (6 on the bottom side), 42 nets.
