WesternHAB/HAB360/L-COM system/EAGLE files/_archive/Testing adapters/CH340G adapter/CH340G adapter.brd

## EAGLE design L-COM system/EAGLE files/_archive/Testing adapters/CH340G adapter/CH340G adapter.brd (2020-06-25, an earlier design)

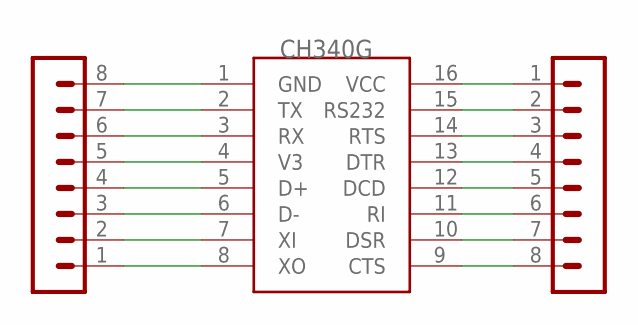
[picture p30: schematic CH340G adapter.sch]

Parts:
SV1, SV2: MA08-1
U$1: CH340G; SOIC16

Connections:
unnamed: SV1.8, U$1.1 (GND)
unnamed: SV1.7, U$1.2 (TX)
unnamed: SV1.6, U$1.3 (RX)
unnamed: SV1.5, U$1.4 (V3)
unnamed: SV1.4, U$1.5 (D+)
unnamed: SV1.3, U$1.6 (D-)
unnamed: SV1.2, U$1.7 (XI)
unnamed: SV1.1, U$1.8 (XO)
unnamed: SV2.8, U$1.9 (CTS)
unnamed: SV2.7, U$1.10 (DSR)
unnamed: SV2.6, U$1.11 (RI)
unnamed: SV2.5, U$1.12 (DCD)
unnamed: SV2.4, U$1.13 (DTR)
unnamed: SV2.3, U$1.14 (RTS)
unnamed: SV2.2, U$1.15 (RS232)
unnamed: SV2.1, U$1.16 (VCC)

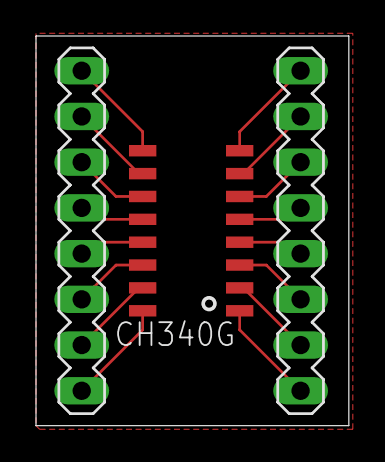
[picture p31: board CH340G adapter.brd from above]

Board: 2 copper layers, 17.4 x 21.6 mm, 3 parts (0 on the bottom side), 16 nets.
