WesternHAB/HAB360/L-COM system/Software/LCOM/RadioController.h

#define INC_RADIOCONTROLLER_H_
#include <Arduino.h>
#include <RadioLib.h>
#include "Utility.h"
    #define NSS                             10
    #define DIO1                            2
    #define NRST                            9
    #define BUSY                            8
    #define RX                              6 //7 (had these swapped by accident?)
    #define TX                              7 //6
    #define DEFAULT_FREQUENCY               915.0                   // Canadian unlicensed band
    #define DEFAULT_BANDWIDTH               125.0
    #define DEFAULT_SPREADING_FACTOR        9
    #define DEFAULT_CODING_RATE             7
    #define DEFAULT_SYNC_WORD               0x12                    // (private network)
    #define DEFAULT_OUTPUT_POWER            14                      // (max 22 dBm)
    #define DEFAULT_PREAMBLE_LENGTH         8
    #define DEFAULT_CURRENT_LIMIT           60.0                    // (max 140 mA)
    #define MAX_LORA_MESSAGE_SIZE           255
    #define NO_NEW_RADIO_DATA               0x0201
    int16_t initializeRadio(void);
    void receiveCallback(void);
    int16_t readRadioData(void);
    uint8_t* getRadioData(void);
    uint16_t getRadioDataLength(void);
    int16_t transmitRadio(uint8_t* buf, uint16_t len);
    int16_t setRadioParameters(
        float _frequency, float _bandwidth, uint8_t _spreadingFactor, uint8_t _codingRate,
        uint8_t _syncWord, int8_t _power, uint16_t _preambleLength, float _currentLimit
    );
    bool getLoRaSet(void);
    int16_t resetRadio(void);
    float getFrequency(void);
    float getBandwidth(void);
    uint8_t getSpreadingFactor(void);
    uint8_t getCodingRate(void);
    uint8_t getSyncWord(void);
    uint8_t getPower(void);
    uint16_t getPreambleLength(void);
    float getCurrentLim(void);
    uint32_t getTOA(void);
    float getLoRaDataRate(void);
    float getMessageRSSI(void);
    float getMessageSNR(void);
