WesternHAB/HAB360/(commit log)

2020-06-25 L-COM and power system notes/files
    [CH340G adapter.brd, CH340G adapter.sch, comms_sys_schematic.brd, comms_sys_schematic.sch, scem.brd, scem.sch]
2020-08-26 New files - small errors
    NOTE: in the schematic, the UART interface to the ATMEGA328 UART pins is wrong.
    The molex Tx should voltage divide to the 3.3V Rx of the ATMEGA, and a pull-up resistor + LED on the 3.3V segment
    The ATMEGA Tx should pass through a 1K current-limiting resistor to the Molex Rx (no voltage division needed). A pull-up resistor and LED should be on the segment of wire between the ATMEGA and 1K resistor.
    The parts list does not accurately reflect the current state and needs to be updated.
    [CH340G adapter.brd, CH340G adapter.sch, comms_sys_schematic.brd, comms_sys_schematic.sch, comms_sys_schematic_no_ch340G.brd, comms_sys_schematic_no_ch340G.sch, scem.brd, scem.sch]
2020-10-02 Updated board design
    Reddit gave some reccomendations
    [comms_sys_schematic_R2.brd, comms_sys_schematic_R2.sch, comms_sys_schematic_no_ch340G.brd]
2020-10-08 Touch-ups to board
    Small changes to the board, namely ensuring the antenna trace is properly designed (40 mil width for antenna-matching 50-Ohm impedance, via fence, removal of thermal reliefs on SMA connector).
    [comms_sys_schematic_R2.brd, comms_sys_schematic_R2.sch]
2020-10-22 Various improvements/corrections
    Posted on Reddit, applied reccomendations
    [comms_sys_schematic_V1.brd, comms_sys_schematic_V1.sch]
2020-10-23 Small fixes to board. Created parts list
    Still need to source resistors, capacitors, fuses, etc.
    Some of the components may be sourced from elsewhere for a lot cheaper, but this list keeps it all in Digikey.
    [Parts.xlsx, comms_sys_schematic_V1.brd, comms_sys_schematic_V1.sch]
2020-10-30 V1 design finished, full parts list
    First version finished, complete parts list put together.
    Boards currently ordered from PCBWay to try out the design.
    [Parts.xlsx, comms_sys_schematic_V1.brd, comms_sys_schematic_V1.sch]
2020-11-26 Moving files
    Moved all desktop work into the repo so its not in two places.
    [CH340G adapter.brd, CH340G adapter.sch, Parts.xlsx, comms_sys_schematic_R2.brd, comms_sys_schematic_R2.sch, comms_sys_schematic_V1.brd, comms_sys_schematic_V1.sch, scem.brd]
2020-11-26 Replaced footprints for tantalum capacitors
    Swapped out the tantalum capacitor's footprints for a slightly different one. Includes polarity marking on silkscreen.
    [comms_sys_schematic_V1.brd, comms_sys_schematic_V1.sch]
2020-12-08 Small change to screws
    Modified them to 2.2mm in diameter. Seems the fab house changed them from 3mm to 2.2mm in the order, which actually worked out better for fitting screws in.
    The 'top-left' screw (between pin header and ICSP header) was moved 0.3mm to the right to allow more of the ground plane to connect. Will be reflected in the 3D model of the casing.
    [Parameter change, repeater.txt, Parts.xlsx, comms_sys_schematic_V1.brd]
2020-12-29 Board images, directory renamed
    Images of the first two (one working, the other mostly working) boards. Renamed directory because I don't want to bother thinking of another name for it at this point.
    [CH340G adapter.brd, CH340G adapter.sch, Parameter change, repeater.txt, Parts.xlsx, comms_sys_schematic_R2.brd, comms_sys_schematic_R2.sch, comms_sys_schematic_V1.brd, comms_sys_schematic_V1.sch]
2021-02-04 LCOM-V2 update
    Updated to V2 of the board. Solved remaining outstanding issues (and hopefully did not introduce new ones).
    -Switched the DIO1 of EBYTE module to connected to interrupt pin PD2 of the ATMEGA.
    -Switched EBYTE rx/tx pins to PD6 and PD7 of ATMEGA.
    -Added an optional connection (by adding 0R resistor) to DIO2 of EBYTE.
    -Spaced ground plane from Vin traces to prevent arcing.
    -Moved C1 and C2 to backside, repositioned L1 to allow for cleaning around it.
    -Updated specifications file, added pin usage.
    Also added basic example code for receive and transmit using the interrupt on DIO1.
    [LCOM_V2_specifications.xlsx, Parts.xlsx, Parts_V1.xlsx, comms_sys_schematic_V1.brd, comms_sys_schematic_V1.sch, comms_sys_schematic_V2.brd, comms_sys_schematic_V2.sch]
2021-09-27 Software, documentation
    [LCOM_V2_specifications.xlsx]
2021-10-01 GUI fix, removed set COM port and allowed choice
    [GUI.py]
