WesternHAB/HAB360/(notices)

Notices in the files:
parts and their libraries:
Wurth_Elektronik_Electromechanic_Switch_: Copyright: Würth Elektronik
